metanurb21/esp32_igbt_driver/(commit log)

2025-02-18 chore(induction): adding board image
2025-02-18 chore(induction): updating readme
    [pick_and_place.csv]
